eliftplgl/EE463-Hardware-Project/inductor_mastermind.png

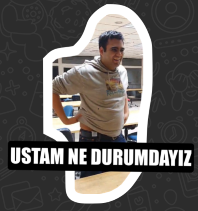
inductor_mastermind.png
