eliftplgl/EE463-Hardware-Project/README.md

# EE463-Hardware-Project
Wind Turbine Battery Charger Hardware Project

Elif Topaloğlu - 2443984

Erkin Atay Toka - 2443968

Doruk Yazıcı - 2517225
