eliftplgl/EE463-Hardware-Project/(commit log)

2023-12-01 First version of the simulation
    Simulation of the overall circuit is implemented and non-idealities added. Topology includes three-phase full-bridge-diode rectifier plus buck converter.
2023-12-02 synchronous buck
    diode rectifier + synchronous buck circuit is added
2023-12-03 Simulation result figures
    Figures for the simulation results of both classical buck and synchronous buck topologies
2023-12-08 Initial Inductor Design
    Initial inductor design for soft magnetic material in laboratory
2023-12-14 New Inductor Design MATLAB code
    The Al vs NI curve is obtained from the Magnetics. A fixed point iteration code is written for the inductor design
2024-01-02 Controller codes for buck converter
    buck_converter_controller.ino is the latest version while digital_controller is the old version which is assumed and experimented to be working
2024-01-07 codes for control of buck
